Emute-Lab-Instruments/ELI2350/ELI2350.kicad_pcb

## KiCad design ELI2350.kicad_pcb (2026-05-14)

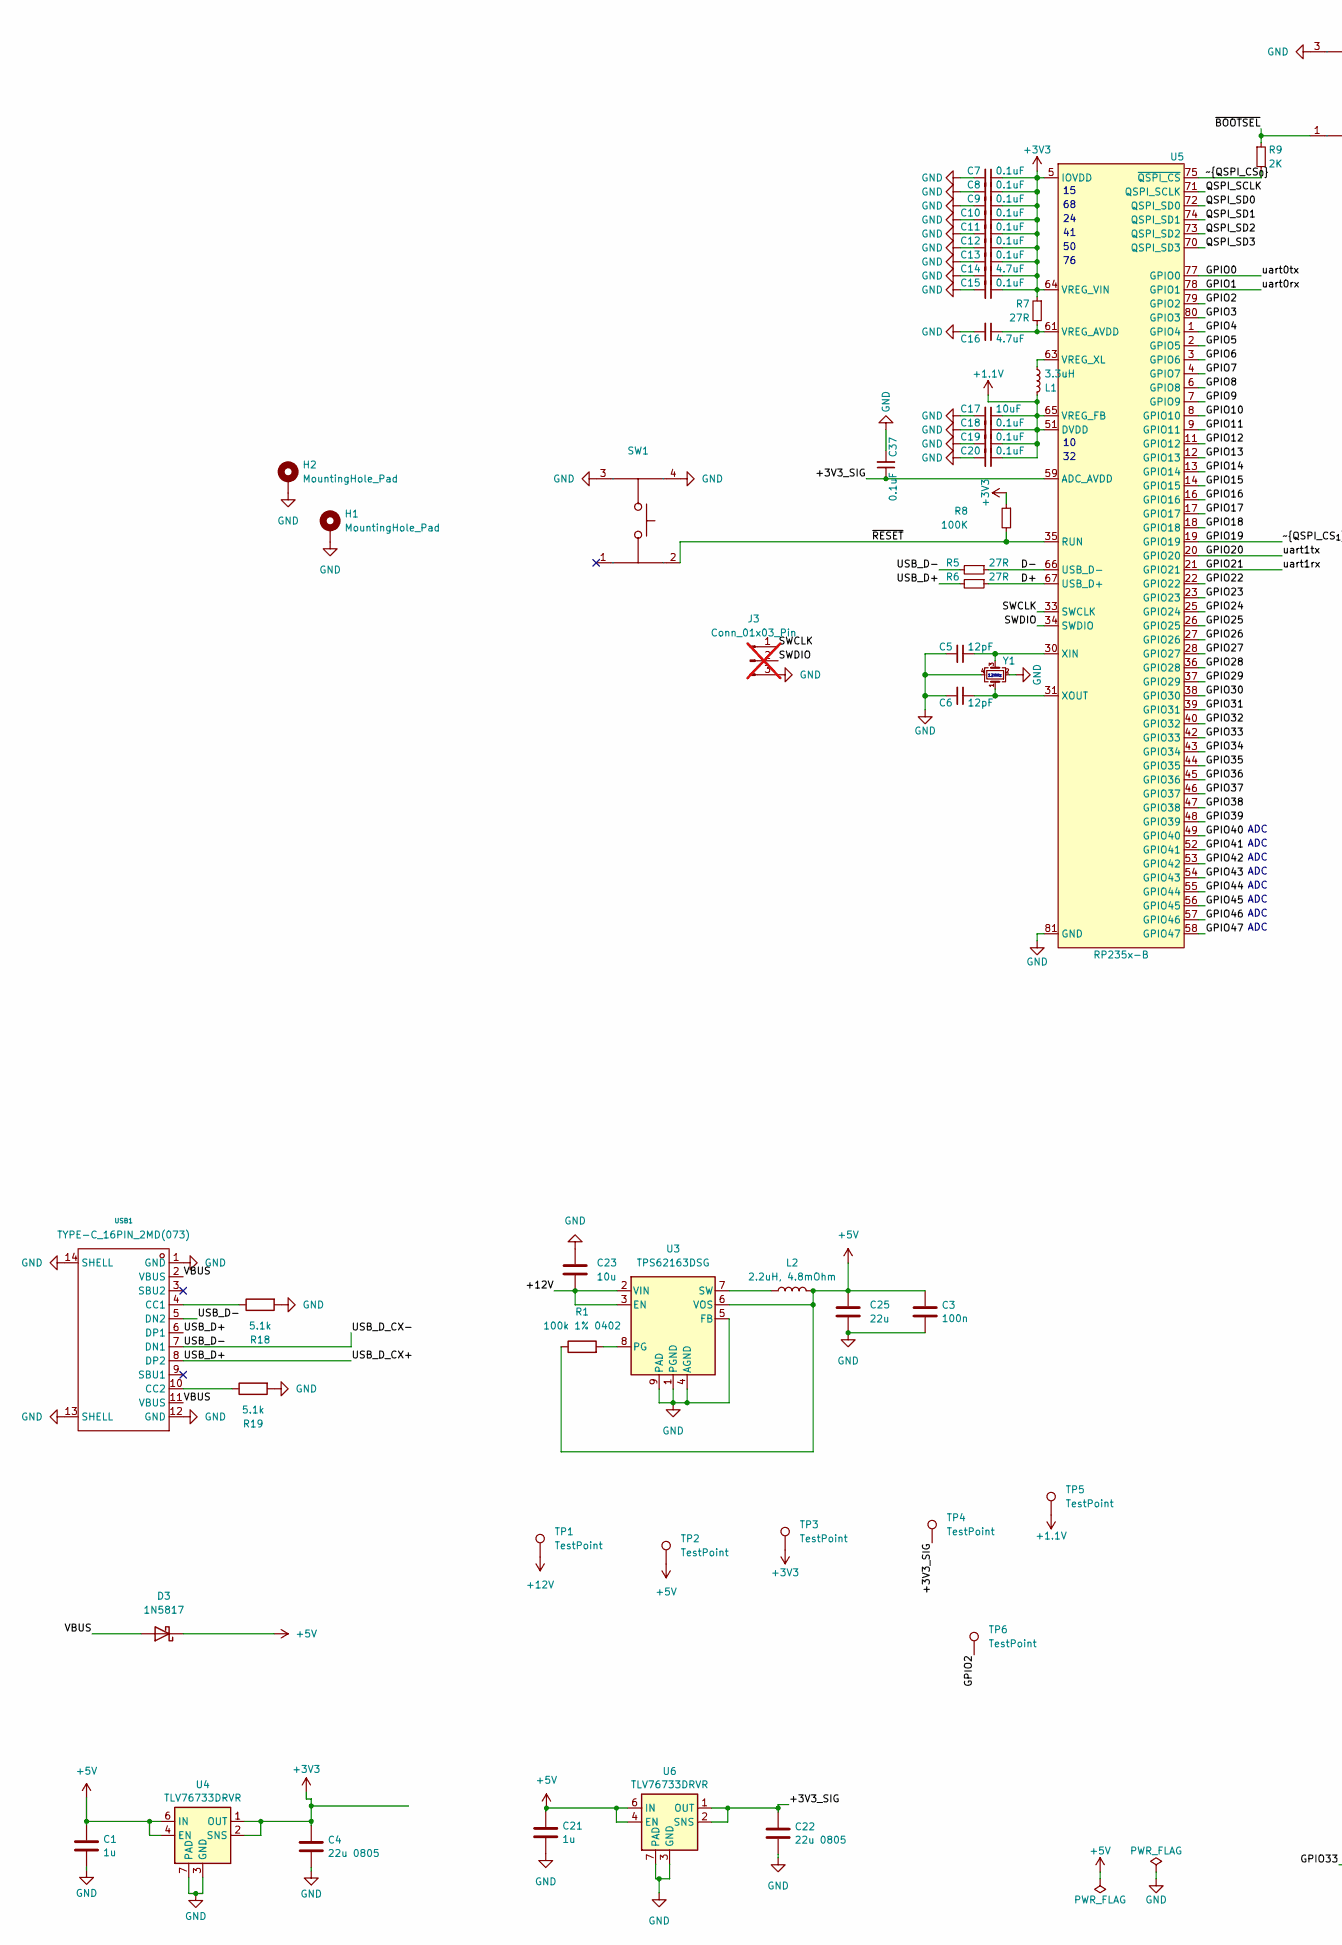
[picture p1: schematic ELI2350.kicad_sch, MEML System Board, part in row 1, column 1]

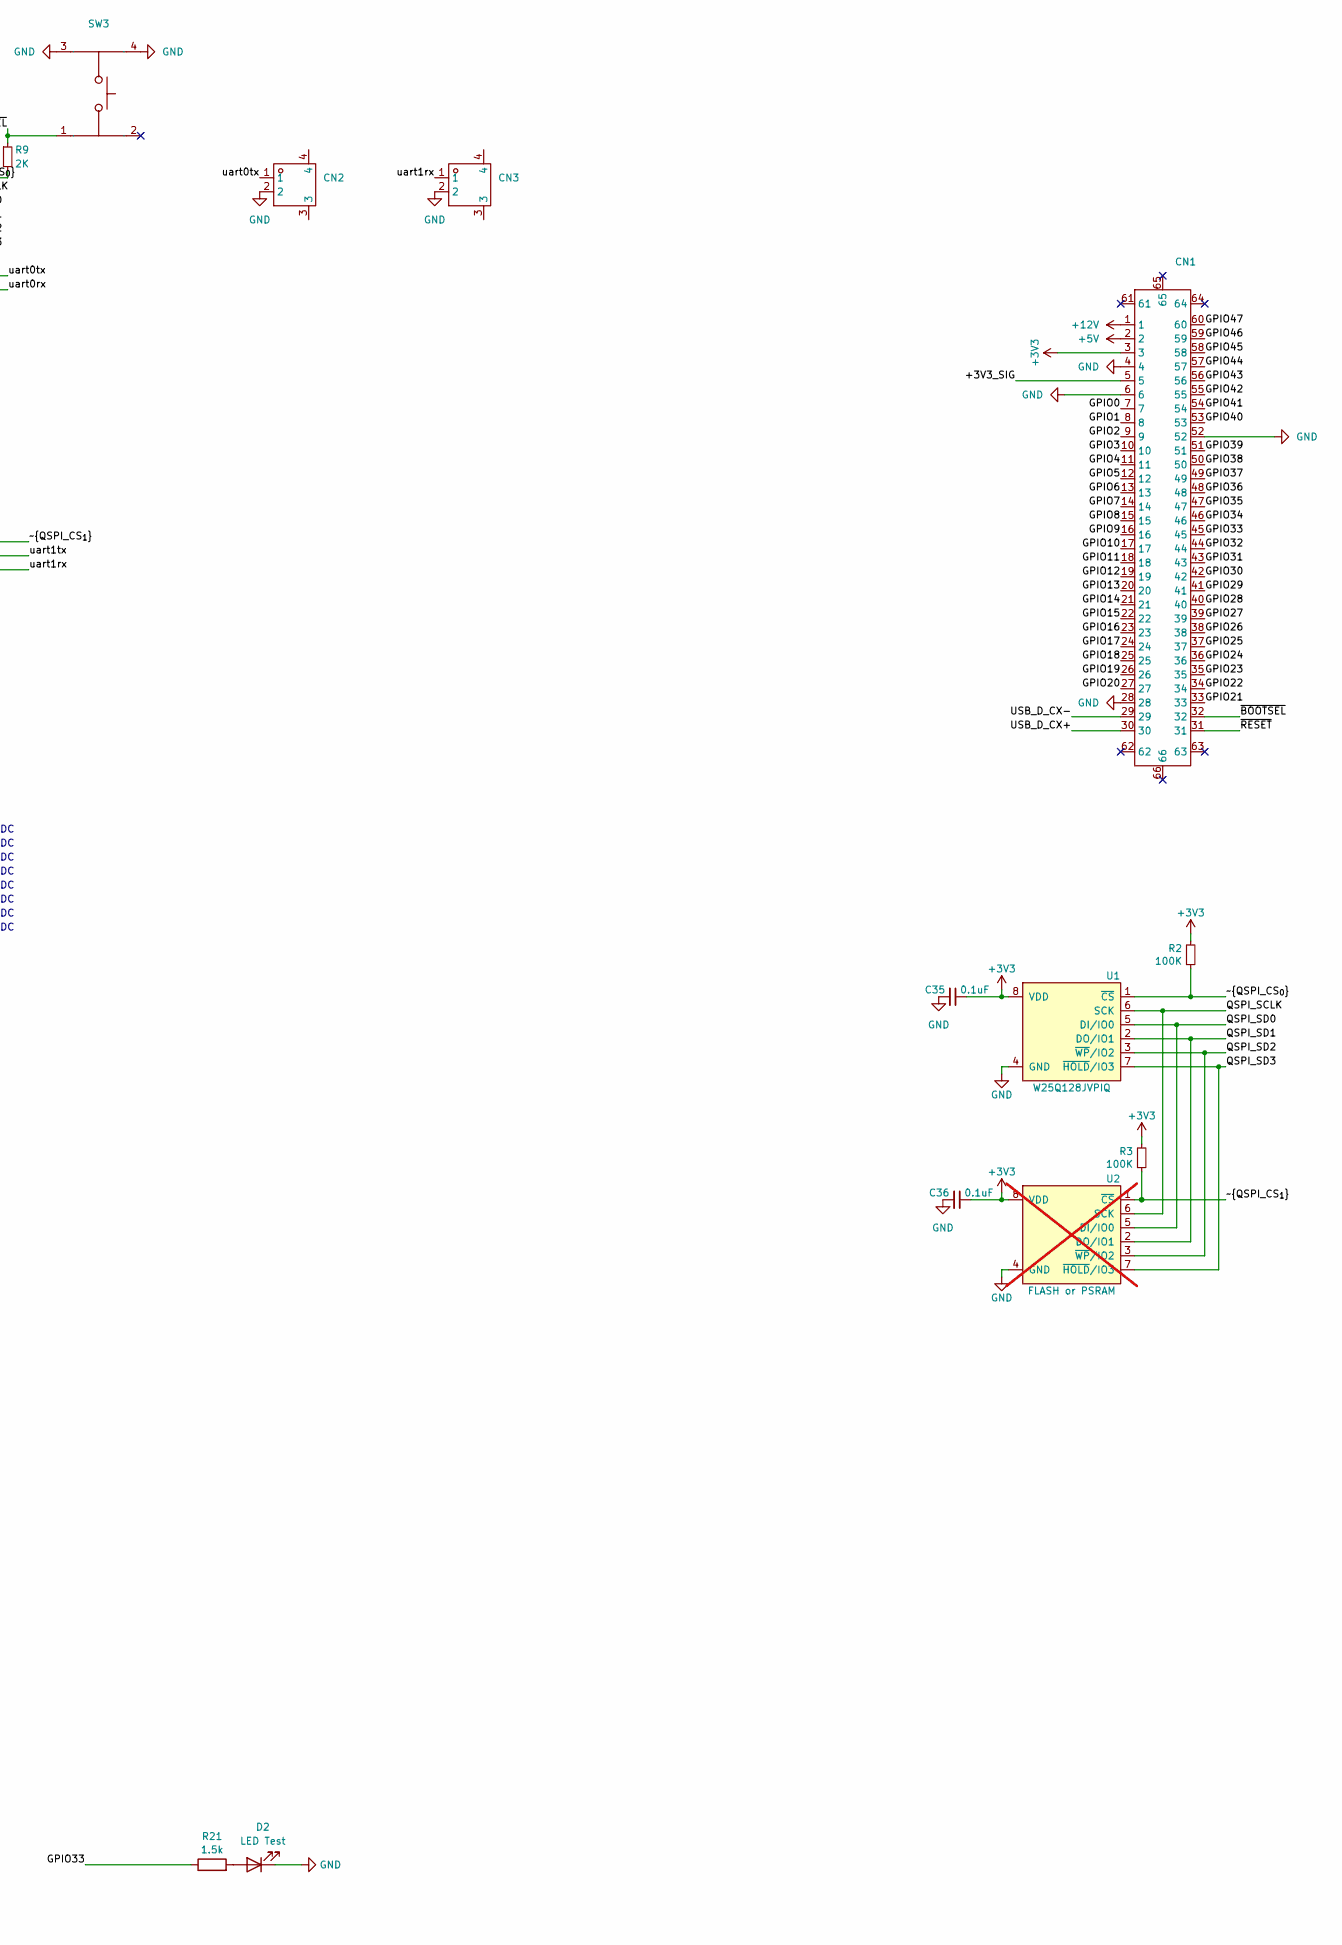
[picture p2: schematic ELI2350.kicad_sch, MEML System Board, part in row 1, column 2]

Parts:
C1, C21: 1u; C_0603_1608Metric_Pad1.08x0.95mm_HandSolder
C3: 100n; C_0603_1608Metric
C4, C22: 22u 0805; C_0805_2012Metric_Pad1.18x1.45mm_HandSolder
C5, C6: 12pF; C_0603_1608Metric
C7, C8, C9, C10, C11, C12, C13, C15, C18, C19, C20, C35, C36, C37: 0.1uF; C_0603_1608Metric
C14, C16: 4.7uF; C_0603_1608Metric
C17: 10uF; C_0603_1608Metric
C23: 10u; C_0805_2012Metric
C25: 22u; C_0805_2012Metric
CN1: CONN-SMD_60P-P0.50_HCTL_HC-PBB23L-60DS-0.5V-G2-01; Manufacturer Part HC-PBB23L-60DS-0.5V-G2-01; JLC C22390096
CN2, CN3: CONN-SMD_2P-P1.50_XUNPU_WAFER-ZH1.5-2PWB; Manufacturer Part WAFER-ZH1.5-2PWB; JLC C3029422
D2: LED Test; LED_0805_2012Metric
D3: 1N5817; D_SOD-323
H1, H2: MountingHole_Pad; MountingHole_2.2mm_M2_Pad
J3: Conn_01x03_Pin; PinHeader_1x03_P2.54mm_Vertical_SMD_Pin1Left; not fitted
L1: 3.3uH; IND-SMD_L2.0-W1.6_AOTA-B201610S3R3-101-T; JLC C42411119
L2: 2.2uH, 4.8mOhm; L_Sunlord_SWPA4020S
R1: 100k 1% 0402; R_0402_1005Metric
R2, R3, R8: 100K; R_0603_1608Metric
R5, R6, R7: 27R; R_0603_1608Metric
R9: 2K; R_0603_1608Metric
R18, R19: 5.1k; R_0402_1005Metric
R21: 1.5k; R_0603_1608Metric
SW1, SW3: SW-SMD_4P-L3.5-W2.9-P1.30-LS4.8; Manufacturer Part SKSCLAE010; JLC C130445
TP1, TP2, TP3, TP4, TP5, TP6: TestPoint; TestPoint_Pad_1.5x1.5mm
U1: W25Q128JVPIQ; WSON-8-1EP_6x5mm_P1.27mm_EP3.4x4mm; JLC C190862
U2: FLASH or PSRAM; SSOP-8_5.25x5.24mm_P1.27mm; not fitted
U3: TPS62163DSG; WSON-8-1EP_2x2mm_P0.5mm_EP0.9x1.6mm_ThermalVias; JLC C97534
U4, U6: TLV76733DRVR; WSON-6-1EP_2x2mm_P0.65mm_EP1x1.6mm_ThermalVias; JLC C2848334
U5: RP235x-B; QFN-80_EP_10x10_Pitch0.4mm; JLC C42415655
USB1: TYPE-C_16PIN_2MD(073); USB-C-SMD_TYPE-C-6PIN-2MD-073; JLC C2765186
Y1: CM4012M00012001; Crystal_SMD_2520-4Pin_2.5x2.0mm; LCSC C7294610

Connections:
+1.1V: C17.1, C18.1, C19.1, C20.1, L1.2, TP5.1, U5.10 (DVDD), U5.32 (DVDD), U5.51 (DVDD), U5.65 (VREG_FB)
+3V3: C4.1, C7.1, C8.1, C9.1, C10.1, C11.1, C12.1, C13.1, C14.1, C15.1, C35.1, C36.1, CN1.3, R2.2, R3.2, R7.1, R8.1, TP3.1, U1.8 (VDD), U2.8 (VDD), U4.1 (OUT), U4.2 (SNS), U5.5 (IOVDD), U5.15 (IOVDD), U5.24 (IOVDD), U5.29 (IOVDD), U5.41 (IOVDD), U5.50 (IOVDD), U5.60 (IOVDD), U5.64 (VREG_VIN), U5.68 (IOVDD), U5.69 (IOVDD), U5.76 (IOVDD)
+5V: C1.1, C3.1, C21.1, C25.1, CN1.2, D3.1 (K), L2.2, R1.1, TP2.1, U3.6 (VOS), U4.4 (EN), U4.6 (IN), U6.4 (EN), U6.6 (IN)
+12V: C23.2, CN1.1, TP1.1, U3.2 (VIN), U3.3 (EN)
/+3V3_SIG: C22.1, C37.1, CN1.5, TP4.1, U5.59 (ADC_AVDD), U6.1 (OUT), U6.2 (SNS)
/D+: R6.1, U5.67 (USB_D+)
/D-: R5.1, U5.66 (USB_D-)
/GPIO0: CN1.7, CN2.1, U5.77 (GPIO0)
/GPIO1: CN1.8, U5.78 (GPIO1)
/GPIO2: CN1.9, TP6.1, U5.79 (GPIO2)
/GPIO3: CN1.10, U5.80 (GPIO3)
/GPIO4: CN1.11, U5.1 (GPIO4)
/GPIO5: CN1.12, U5.2 (GPIO5)
/GPIO6: CN1.13, U5.3 (GPIO6)
/GPIO7: CN1.14, U5.4 (GPIO7)
/GPIO8: CN1.15, U5.6 (GPIO8)
/GPIO9: CN1.16, U5.7 (GPIO9)
/GPIO10: CN1.17, U5.8 (GPIO10)
/GPIO11: CN1.18, U5.9 (GPIO11)
/GPIO12: CN1.19, U5.11 (GPIO12)
/GPIO13: CN1.20, U5.12 (GPIO13)
/GPIO14: CN1.21, U5.13 (GPIO14)
/GPIO15: CN1.22, U5.14 (GPIO15)
/GPIO16: CN1.23, U5.16 (GPIO16)
/GPIO17: CN1.24, U5.17 (GPIO17)
/GPIO18: CN1.25, U5.18 (GPIO18)
/GPIO19: CN1.26, R3.1, U2.1 (~CS), U5.19 (GPIO19)
/GPIO20: CN1.27, U5.20 (GPIO20)
/GPIO21: CN1.33, CN3.1, U5.21 (GPIO21)
/GPIO22: CN1.34, U5.22 (GPIO22)
/GPIO23: CN1.35, U5.23 (GPIO23)
/GPIO24: CN1.36, U5.25 (GPIO24)
/GPIO25: CN1.37, U5.26 (GPIO25)
/GPIO26: CN1.38, U5.27 (GPIO26)
/GPIO27: CN1.39, U5.28 (GPIO27)
/GPIO28: CN1.40, U5.36 (GPIO28)
/GPIO29: CN1.41, U5.37 (GPIO29)
/GPIO30: CN1.42, U5.38 (GPIO30)
/GPIO31: CN1.43, U5.39 (GPIO31)
/GPIO32: CN1.44, U5.40 (GPIO32)
/GPIO33: CN1.45, R21.1, U5.42 (GPIO33)
/GPIO34: CN1.46, U5.43 (GPIO34)
/GPIO35: CN1.47, U5.44 (GPIO35)
/GPIO36: CN1.48, U5.45 (GPIO36)
/GPIO37: CN1.49, U5.46 (GPIO37)
/GPIO38: CN1.50, U5.47 (GPIO38)
/GPIO39: CN1.51, U5.48 (GPIO39)
/GPIO40: CN1.53, U5.49 (GPIO40)
/GPIO41: CN1.54, U5.52 (GPIO41)
/GPIO42: CN1.55, U5.53 (GPIO42)
/GPIO43: CN1.56, U5.54 (GPIO43)
/GPIO44: CN1.57, U5.55 (GPIO44)
/GPIO45: CN1.58, U5.56 (GPIO45)
/GPIO46: CN1.59, U5.57 (GPIO46)
/GPIO47: CN1.60, U5.58 (GPIO47)
/QSPI_SCLK: U1.6 (SCK), U2.6 (SCK), U5.71 (QSPI_SCLK)
/QSPI_SD0: U1.5 (DI/IO0), U2.5 (DI/IO0), U5.72 (QSPI_SD0)
/QSPI_SD1: U1.2 (DO/IO1), U2.2 (DO/IO1), U5.74 (QSPI_SD1)
/QSPI_SD2: U1.3 (~WP/IO2), U2.3 (~WP/IO2), U5.73 (QSPI_SD2)
/QSPI_SD3: U1.7 (~HOLD/IO3), U2.7 (~HOLD/IO3), U5.70 (QSPI_SD3)
/SWCLK: J3.1, U5.33 (SWCLK)
/SWDIO: J3.2, U5.34 (SWDIO)
/USB_D+: CN1.30, R6.2, USB1.6 (DP1), USB1.8 (DP2)
/USB_D-: CN1.29, R5.2, USB1.5 (DN2), USB1.7 (DN1)
/VBUS: D3.2 (A), USB1.2 (VBUS), USB1.11 (VBUS)
/~BOOTSEL: CN1.32, R9.1, SW3.1
/~QSPI_CS_{0}: R2.1, R9.2, U1.1 (~CS), U5.75 (~QSPI_CS)
/~RESET: CN1.31, R8.2, SW1.2, U5.35 (RUN)
GND: C1.2, C3.2, C4.2, C5.2, C6.2, C7.2, C8.2, C9.2, C10.2, C11.2, C12.2, C13.2, C14.2, C15.2, C16.2, C17.2, C18.2, C19.2, C20.2, C21.2, C22.2, C23.1, C25.2, C35.2, C36.2, C37.2, CN1.4, CN1.6, CN1.28, CN1.52, CN2.2, CN3.2, D2.1 (K), H1.1, H2.1, J3.3, R18.2, R19.2, SW1.3, SW1.4, SW3.3, SW3.4, U1.4 (GND), U1.9 (GND), U2.4 (GND), U3.1 (PGND), U3.4 (AGND), U3.5 (FB), U3.9 (PAD), U4.3 (GND), U4.5 (GND), U4.7 (PAD), U5.62 (GND), U5.81 (GND), U6.3 (GND), U6.5 (GND), U6.7 (PAD), USB1.1 (GND), USB1.12 (GND), USB1.13 (SHELL), USB1.14 (SHELL), Y1.2, Y1.4
unnamed: D2.2 (A), R21.2
unnamed: R1.2, U3.8 (PG)
unnamed: L2.1, U3.7 (SW)
unnamed: C16.1, R7.2, U5.61 (VREG_AVDD)
unnamed: L1.1, U5.63 (VREG_XL)
unnamed: C5.1, U5.30 (XIN), Y1.3
unnamed: C6.1, U5.31 (XOUT), Y1.1
unnamed: R18.1, USB1.4 (CC1)
unnamed: R19.1, USB1.10 (CC2)

Notes on the sheet:
ADC
12MHz

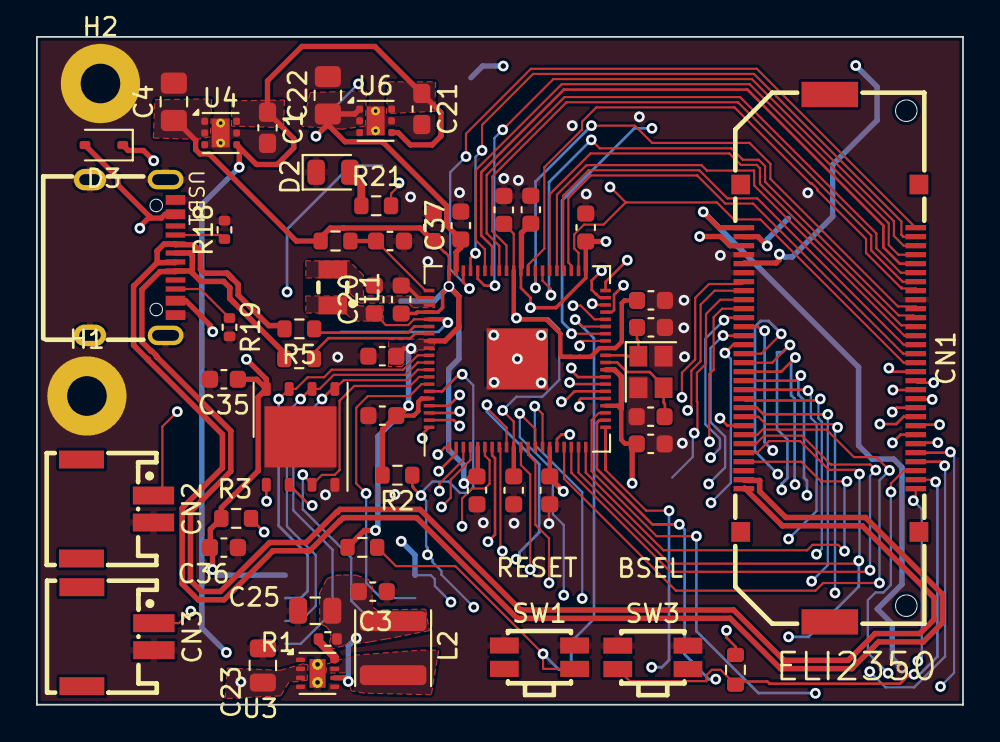
[picture p3: board ELI2350.kicad_pcb from above]

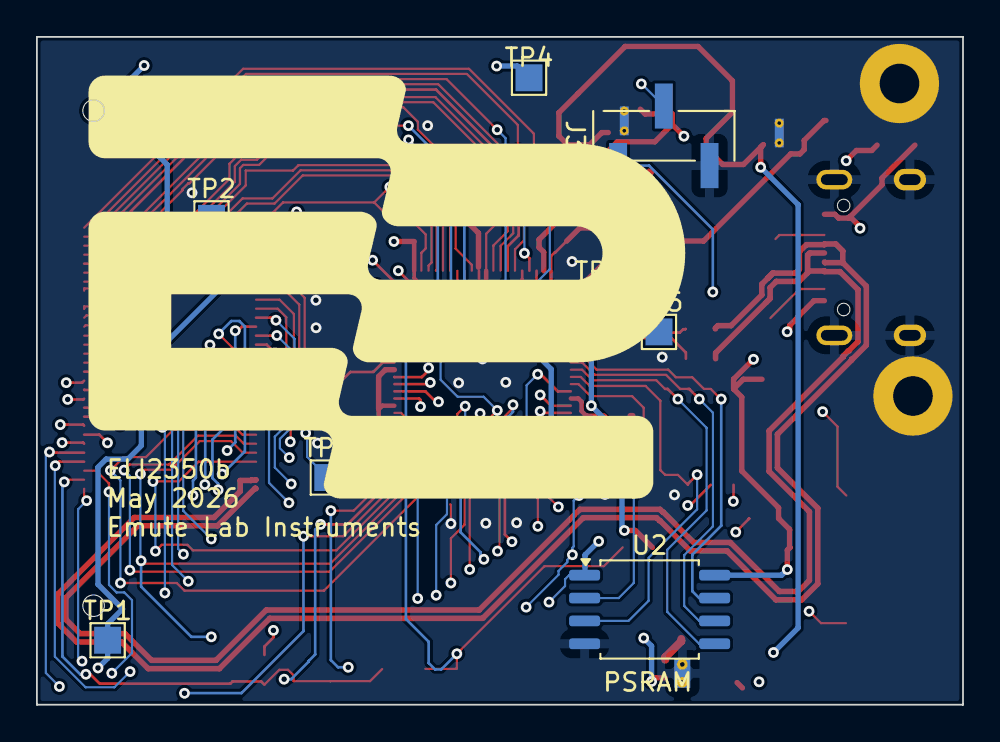
[picture p4: board ELI2350.kicad_pcb from below]

Board: 4 copper layers, 51.4 x 37.1 mm, 63 parts (8 on the bottom side), 78 nets.
