Emute-Lab-Instruments/ELI2350/ELI2350Dock/ELI2350Dock.kicad_pcb

## KiCad design ELI2350Dock/ELI2350Dock.kicad_pcb (2026-05-14)

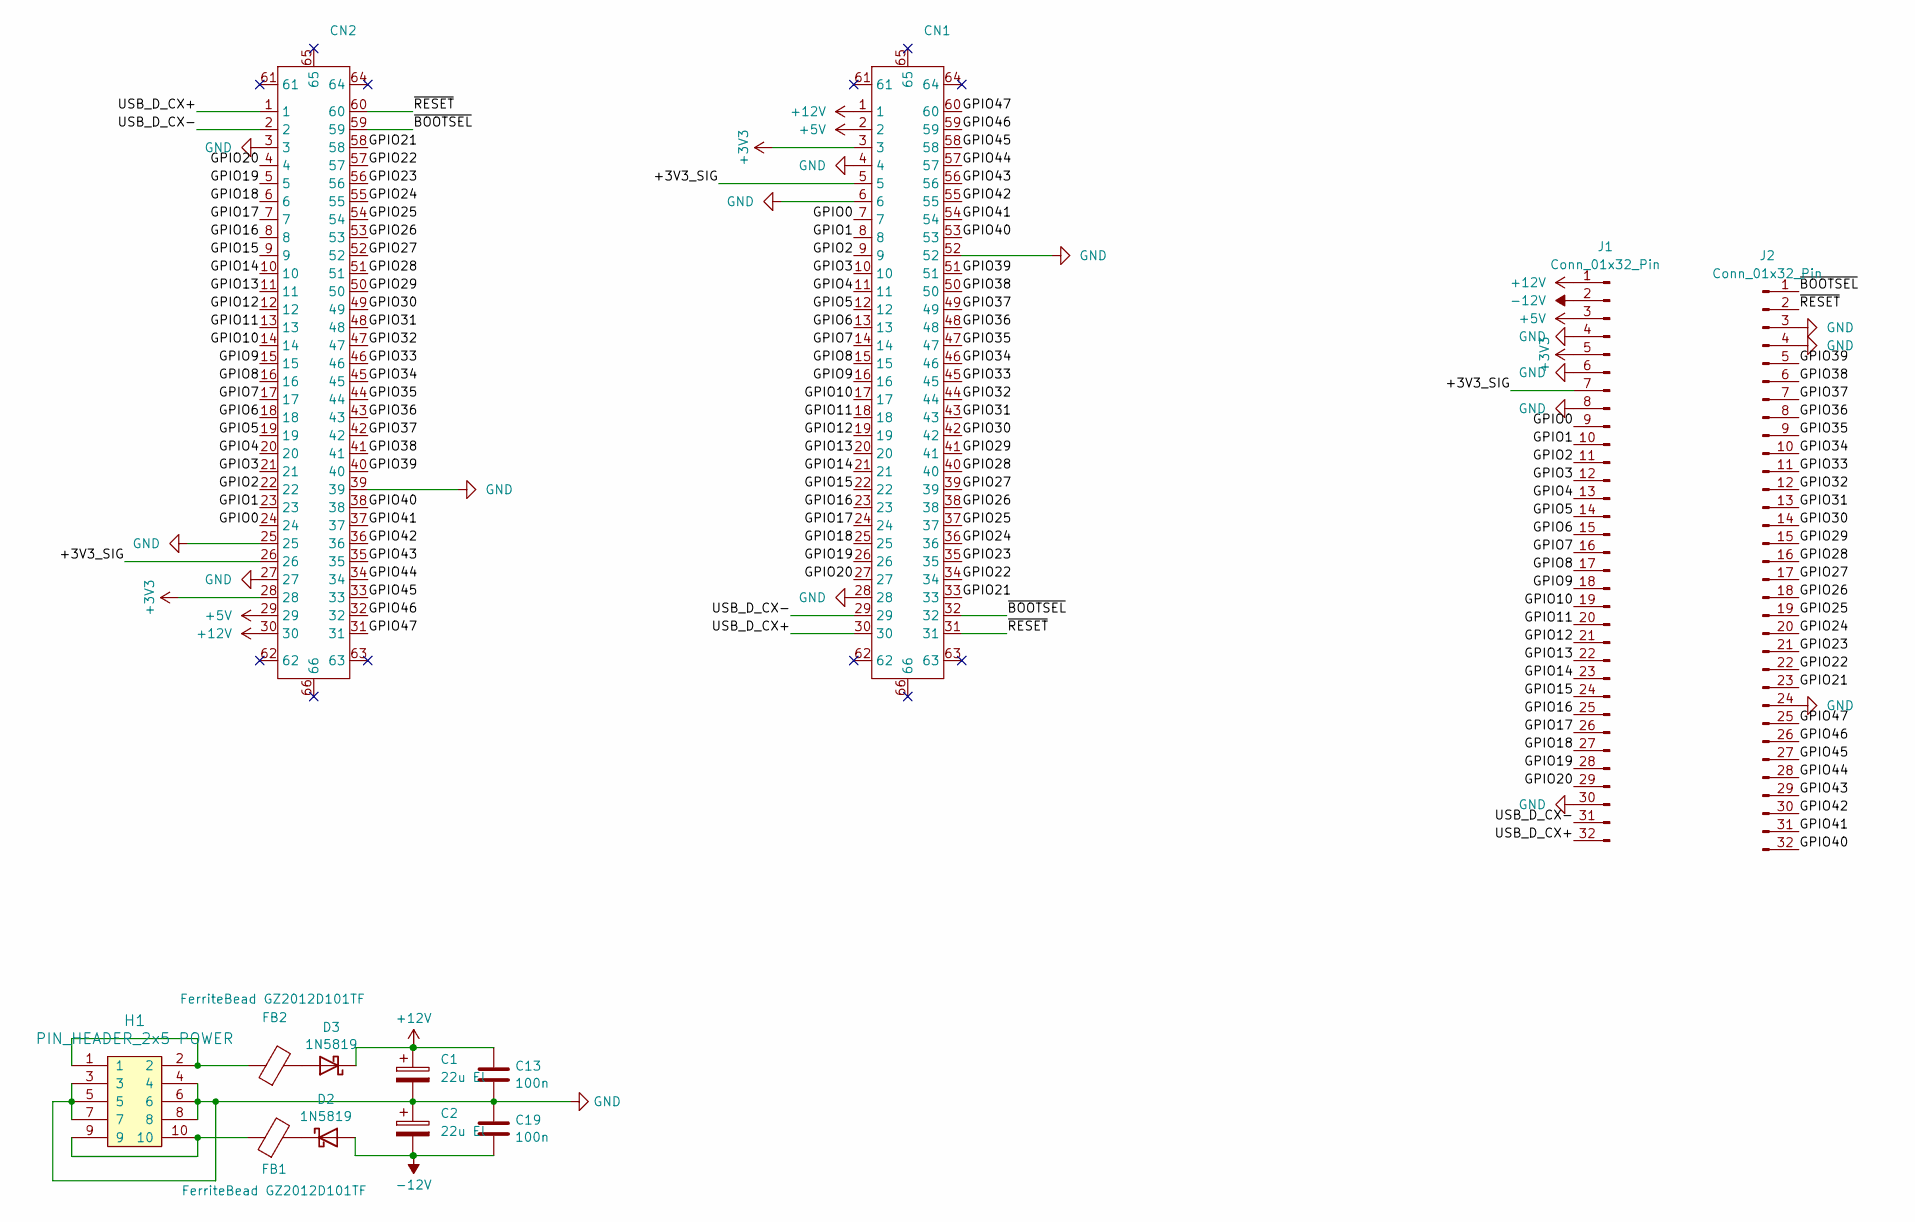
[picture p5: schematic ELI2350Dock.kicad_sch]

Parts:
C1, C2: 22u El; CP_Elec_4x3.9; JLC C250865
C13, C19: 100n; C_0603_1608Metric; JLC C14663
CN1: CONN-SMD_60P-P0.50_HCTL_HC-PBB23L-60DS-0.5V-G2-01; Manufacturer Part HC-PBB23L-60DS-0.5V-G2-01; JLC C22390096
CN2: CONN-SMD_HC-PBB23L-60DP-0.5V10-G2-01; Manufacturer Part HC-PBB23L-60DS-0.5V-G2-01; JLC C22390101
D2: 1N5819; D_SOD-323; JLC C191023
D3: 1N5819; D_SOD-323
FB1, FB2: FerriteBead GZ2012D101TF; R_0805_2012Metric; JLC C1017
H1: PIN_HEADER_2x5 POWER; PinHeader_2x05_P2.54mm_Vertical_SMD; JLC C3294463
J1, J2: Conn_01x32_Pin; PinSocket_1x32_P2.54mm_Vertical

Connections:
+3V3: CN1.3, CN2.28, J1.5
+5V: CN1.2, CN2.29, J1.3
+12V: C1.1, C13.1, CN1.1, CN2.30, D3.1 (K), J1.1
-12V: C2.2, C19.2, D2.2 (A), J1.2
/+3V3_SIG: CN1.5, CN2.26, J1.7
/GPIO0: CN1.7, CN2.24, J1.9
/GPIO1: CN1.8, CN2.23, J1.10
/GPIO2: CN1.9, CN2.22, J1.11
/GPIO3: CN1.10, CN2.21, J1.12
/GPIO4: CN1.11, CN2.20, J1.13
/GPIO5: CN1.12, CN2.19, J1.14
/GPIO6: CN1.13, CN2.18, J1.15
/GPIO7: CN1.14, CN2.17, J1.16
/GPIO8: CN1.15, CN2.16, J1.17
/GPIO9: CN1.16, CN2.15, J1.18
/GPIO10: CN1.17, CN2.14, J1.19
/GPIO11: CN1.18, CN2.13, J1.20
/GPIO12: CN1.19, CN2.12, J1.21
/GPIO13: CN1.20, CN2.11, J1.22
/GPIO14: CN1.21, CN2.10, J1.23
/GPIO15: CN1.22, CN2.9, J1.24
/GPIO16: CN1.23, CN2.8, J1.25
/GPIO17: CN1.24, CN2.7, J1.26
/GPIO18: CN1.25, CN2.6, J1.27
/GPIO19: CN1.26, CN2.5, J1.28
/GPIO20: CN1.27, CN2.4, J1.29
/GPIO21: CN1.33, CN2.58, J2.23
/GPIO22: CN1.34, CN2.57, J2.22
/GPIO23: CN1.35, CN2.56, J2.21
/GPIO24: CN1.36, CN2.55, J2.20
/GPIO25: CN1.37, CN2.54, J2.19
/GPIO26: CN1.38, CN2.53, J2.18
/GPIO27: CN1.39, CN2.52, J2.17
/GPIO28: CN1.40, CN2.51, J2.16
/GPIO29: CN1.41, CN2.50, J2.15
/GPIO30: CN1.42, CN2.49, J2.14
/GPIO31: CN1.43, CN2.48, J2.13
/GPIO32: CN1.44, CN2.47, J2.12
/GPIO33: CN1.45, CN2.46, J2.11
/GPIO34: CN1.46, CN2.45, J2.10
/GPIO35: CN1.47, CN2.44, J2.9
/GPIO36: CN1.48, CN2.43, J2.8
/GPIO37: CN1.49, CN2.42, J2.7
/GPIO38: CN1.50, CN2.41, J2.6
/GPIO39: CN1.51, CN2.40, J2.5
/GPIO40: CN1.53, CN2.38, J2.32
/GPIO41: CN1.54, CN2.37, J2.31
/GPIO42: CN1.55, CN2.36, J2.30
/GPIO43: CN1.56, CN2.35, J2.29
/GPIO44: CN1.57, CN2.34, J2.28
/GPIO45: CN1.58, CN2.33, J2.27
/GPIO46: CN1.59, CN2.32, J2.26
/GPIO47: CN1.60, CN2.31, J2.25
/USB_D_CX+: CN1.30, CN2.1, J1.32
/USB_D_CX-: CN1.29, CN2.2, J1.31
/~BOOTSEL: CN1.32, CN2.59, J2.1
/~RESET: CN1.31, CN2.60, J2.2
GND: C1.2, C2.1, C13.2, C19.1, CN1.4, CN1.6, CN1.28, CN1.52, CN2.3, CN2.25, CN2.27, CN2.39, H1.3, H1.4, H1.5, H1.6, H1.7, H1.8, J1.4, J1.6, J1.8, J1.30, J2.3, J2.4, J2.24
unnamed: D2.1 (K), FB1.2
unnamed: D3.2 (A), FB2.2
unnamed: FB1.1, H1.9, H1.10
unnamed: FB2.1, H1.1, H1.2

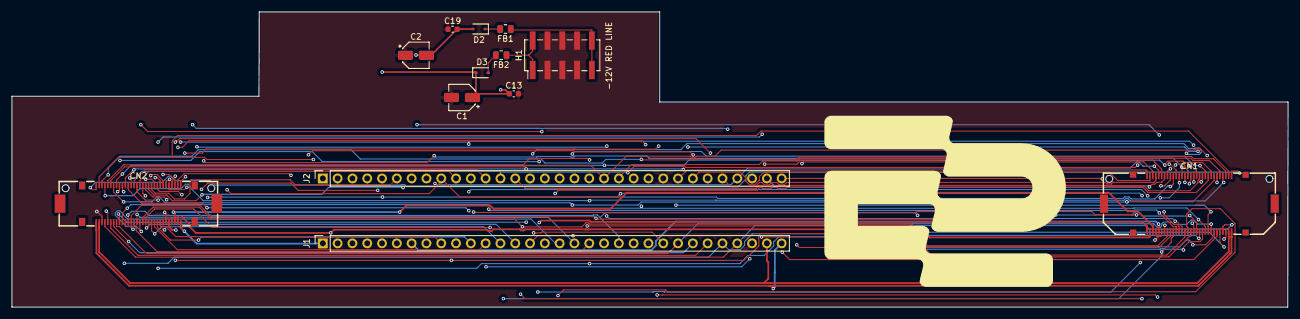
[picture p6: board ELI2350Dock.kicad_pcb from above]

Board: 4 copper layers, 219.0 x 50.7 mm, 13 parts (0 on the bottom side), 62 nets.
