Emute-Lab-Instruments/ELI2350/(commit log)

2025-11-12 dock and near finished compute board
    [BOM-ELI2350Dock.csv, ELI2350.kicad_pcb, ELI2350.kicad_sch, ELI2350Dock.kicad_pcb, ELI2350Dock.kicad_sch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]
2025-11-17 doc pre-reroute
    [BOM-ELI2350.csv, ELI2350.kicad_pcb, ELI2350.kicad_sch, ELI2350Dock.kicad_pcb, ELI2350Dock.kicad_sch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]
